gabriel-baroffaldi/3D_Photometer/README.md

3D Printable LED Photometer © 2025 by Gabriel Baroffaldi Piassalonga, Paulo Clairmont Feitosa de Lima Gomes, São Paulo State University is licensed under Creative Commons Attribution-ShareAlike 4.0 International. To view a copy of this license, visit https://creativecommons.org/licenses/by-sa/4.0/
