gabriel-baroffaldi/3D_Photometer/Readme.pdf

# 3D Printable LED Photometer

### Piassalonga, Gabriel Baroffaldi

gabriel.baroffaldi@unesp.br

de Lima Gomes, Paulo C. F. paulo.clairmont@unesp.br

### February 2025

## 1 Considerations

This photometer was built to be used with a micro-volume cuvette. For other cuvette models, changing the dimensions of the base may be necessary .ipt file.

## 2 List of Materials

- 1x BPW34;
- 1x Switch Mts102;
- 1x OPA344PA;
- 1x Resistor 1 MΩ;
- 1x Resistor 10 MΩ;
- 1x Resistor 220 Ω;
- 1x Potentiometer 10k kΩ;

1

- 2x Polyester Capacitor 10 nF;
- 1x LED;
- 1x Arduino;
- Wire 3 mm gauge.

## 3 Assembly Guide

Glue the photodiode to the recessed wall of the cell holder. Then, on the other side, the LED is glued. Finish the cell holder by gluing “Tampa LED” into the top where the LED was fixed. Be careful if using super glue; their vapors adhere over the LED and photodiode surface in excess.

Figure 1: Cuvette holder

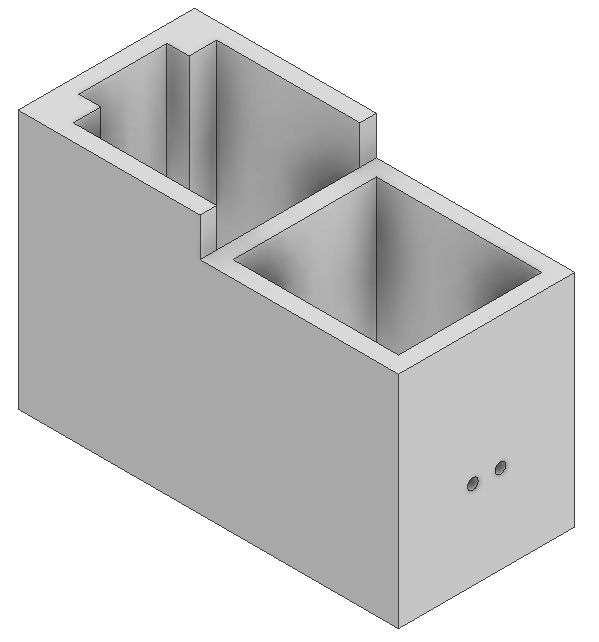
[picture p1: figure]

The PCB board design is provided in the following file: Schematics/Photo-

meter. We recommend that a specialized company produce the board. Solder the electronic components to the circuit board following the schematics:

2

Figure 2: Schematics of the photometer

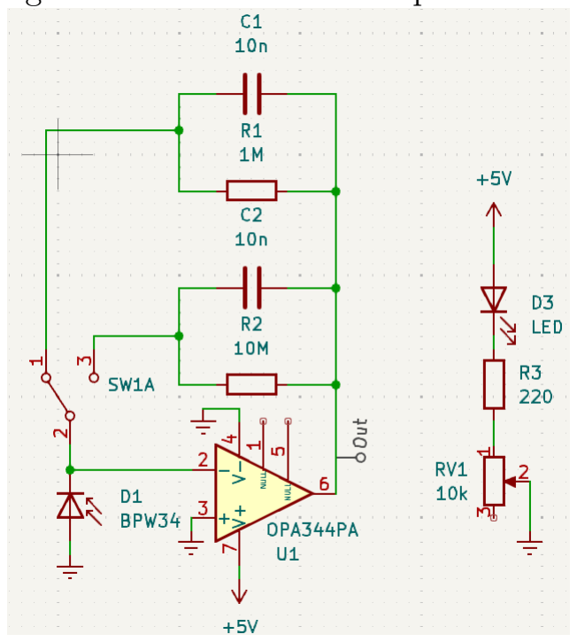
[picture p2: figure]

Place the switch and the potentiometer in the photometer box and measure the wire length necessary to connect the photodiode, LED, potentiometer, and switch Mts102 to the PCB board.
The PCB board needs three wires connected to the Arduino: 5 V, ground, and A0 analog ports. The solder is placed on the board and passes through the side of the box for the Arduino connection.
Glue the cuvette holder to the photometer box and close with the photometer cover.
The Arduino code can be found inside the example library of the Arduino IDE: Examples/Analog/Smoothing.

## 4 How to Use

Using the Serial Monitor from Arduino IDE, change the potentiometer settings to lower the signal.
Place the cuvette and read the value shown inside the Serial Monitor.

3

Absorbance can be calculated using the following formula:

Absorbace = −log(SampleSignal/BlankSample) | (1)

## 5 Dimensions

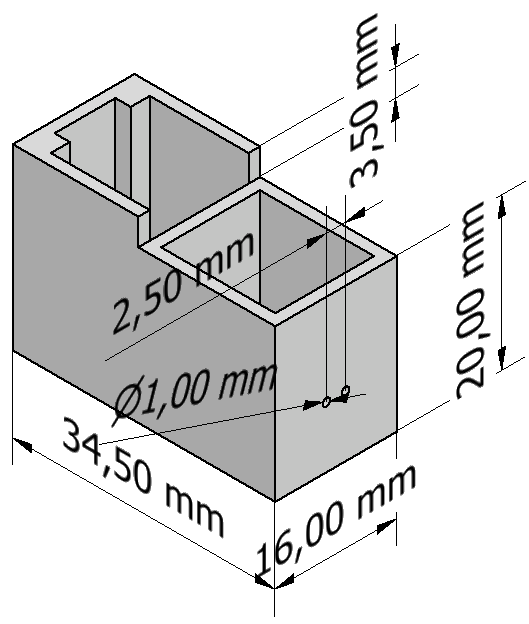
[picture p3: figure]

Figure 3: Dimensions of the cuvette holder.

4

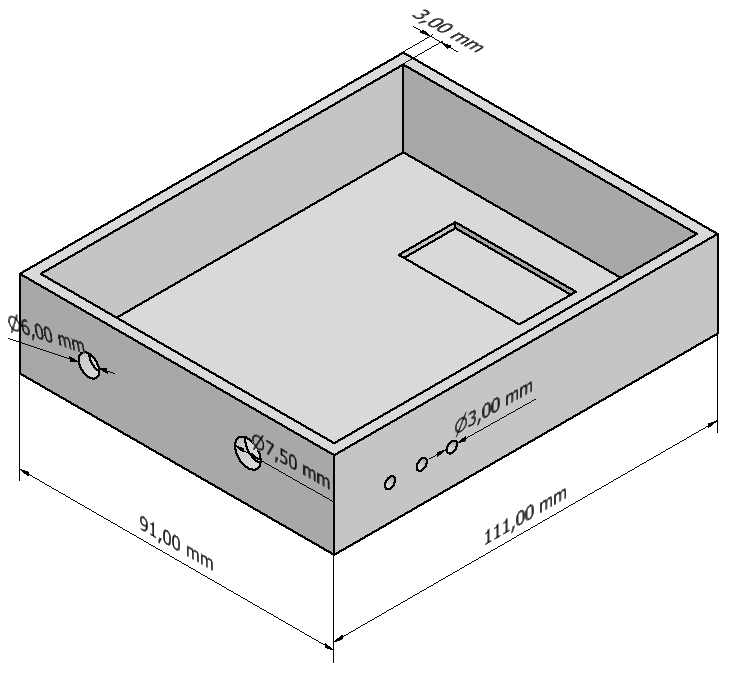
[picture p4: figure]

Figure 4: Dimensions of the photometer box.

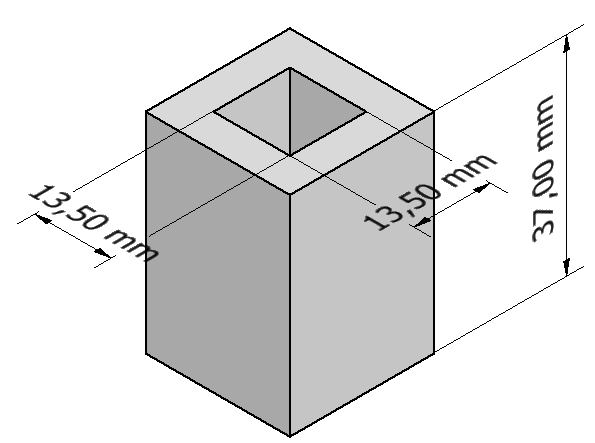
[picture p5: figure]

Figure 5: Dimensions of the cuvette cover.

5

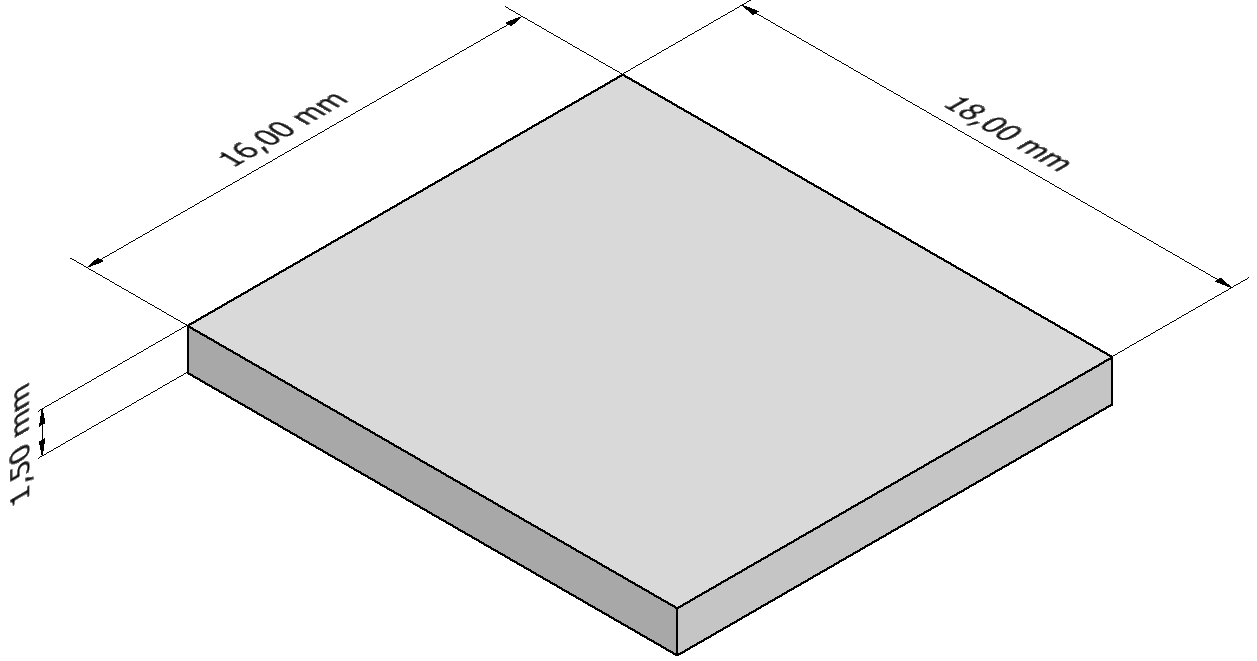
[picture p6: figure]

Figure 6: Dimensions of the LED cover.

Figure 7: Dimensions of the photometer cover.

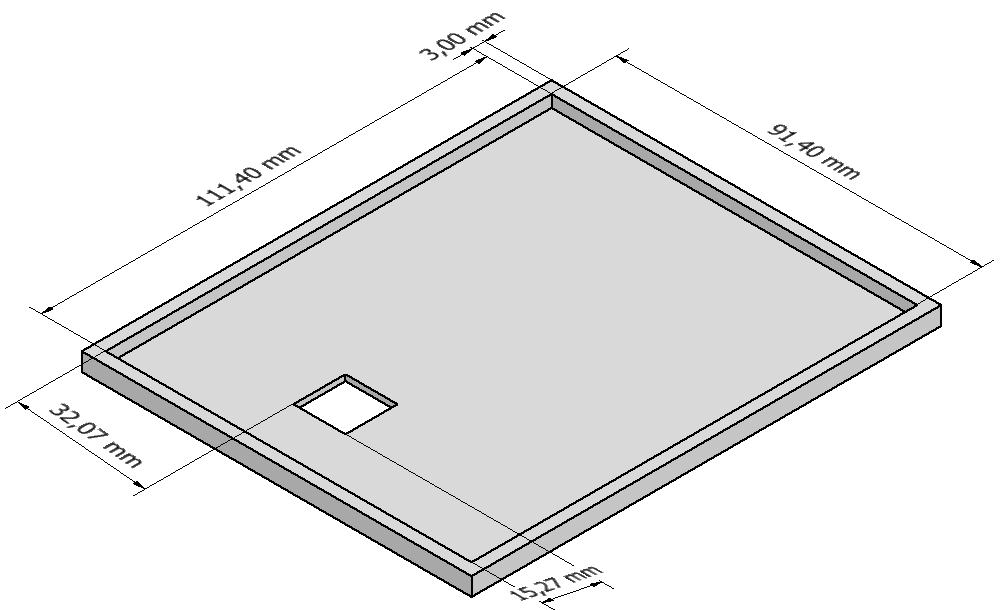
[picture p7: figure]

## 6 License

3D Printable LED Photometer © 2025 by Gabriel Baroffaldi Piassalonga,

Paulo Clairmont Feitosa de Lima Gomes, S˜ao Paulo State University is licensed under Creative Commons Attribution-ShareAlike 4.0 International.

6

To view a copy of this license, visit https://creativecommons.org/licenses/bysa/4.0/

7
