gabriel-baroffaldi/3D_Photometer/CAD/Caixa.stl

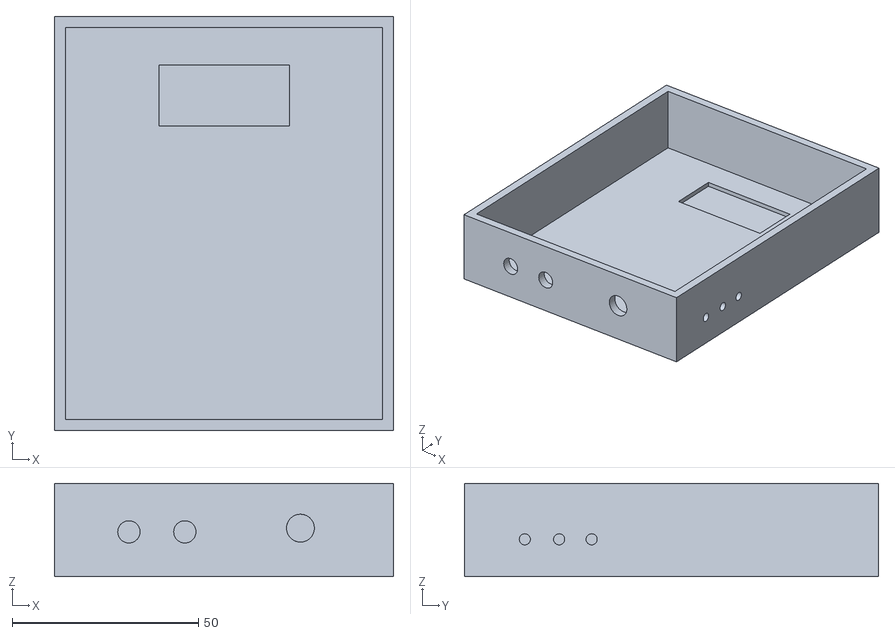
[picture p8: CAD file, 2025-02-11]
CAD/Caixa.stl
91.0 x 111.0 x 25.0
