gabriel-baroffaldi/3D_Photometer/CAD/Base.stl

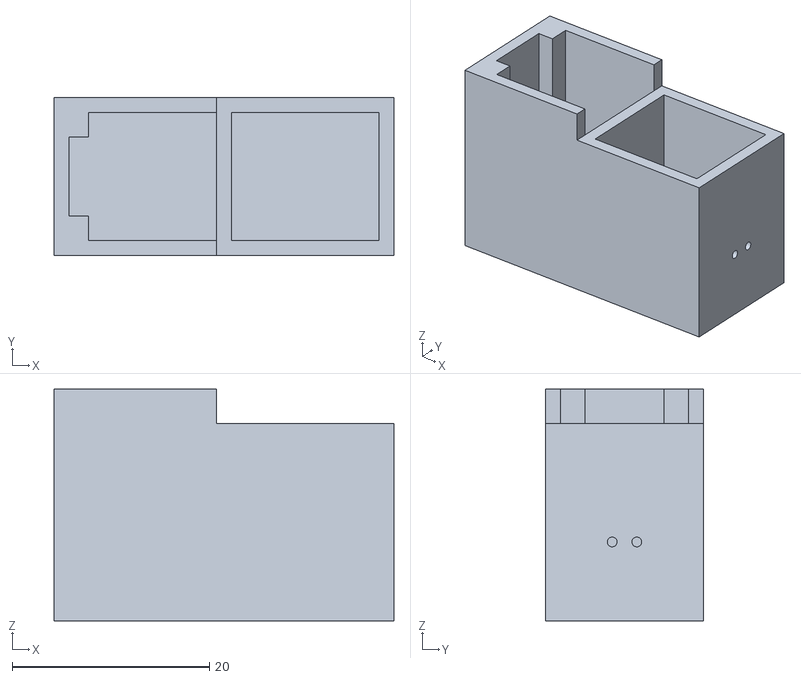
[picture p9: CAD file, 2025-02-10]
CAD/Base.stl
34.5 x 16.0 x 23.5
