gabriel-baroffaldi/3D_Photometer/CAD/Tampa_fotometro.stl

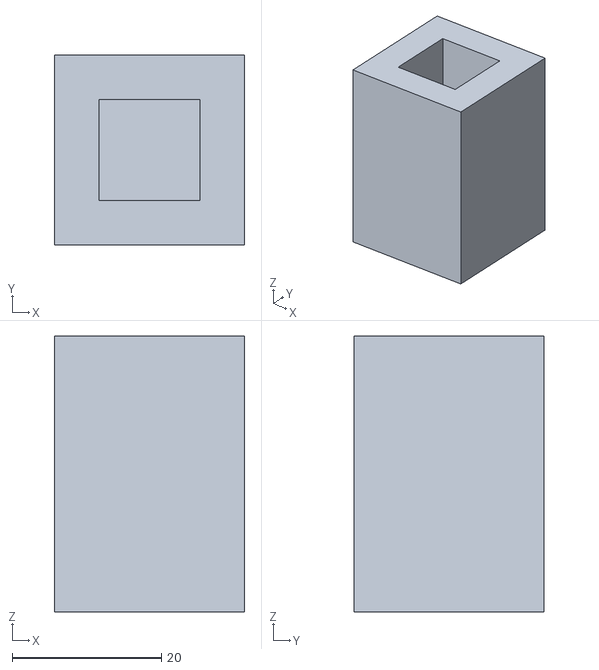
[picture p10: CAD file, 2025-02-10]
CAD/Tampa_fotometro.stl
25.5 x 25.5 x 37.0
