gabriel-baroffaldi/3D_Photometer/CAD/Tampa-led.stl

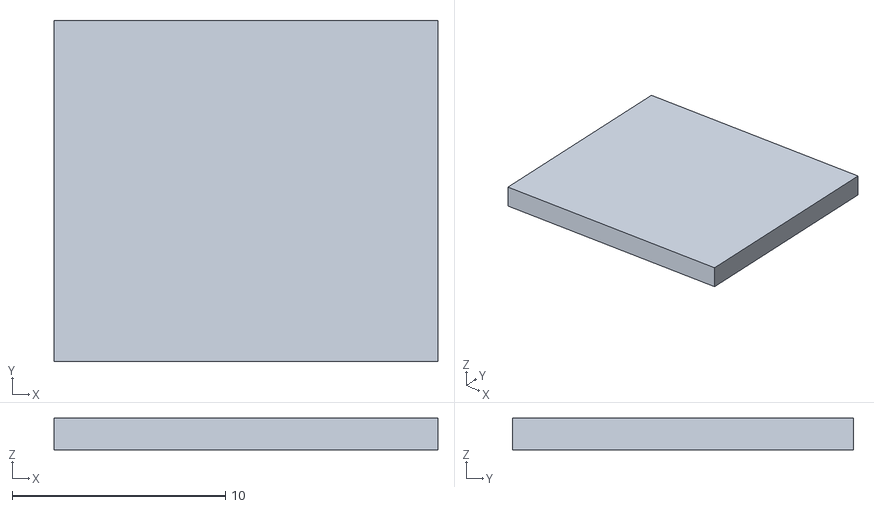
[picture p11: CAD file, 2025-02-10]
CAD/Tampa-led.stl
18.0 x 16.0 x 1.50
