gabriel-baroffaldi/3D_Photometer/CAD/Tampa.stl

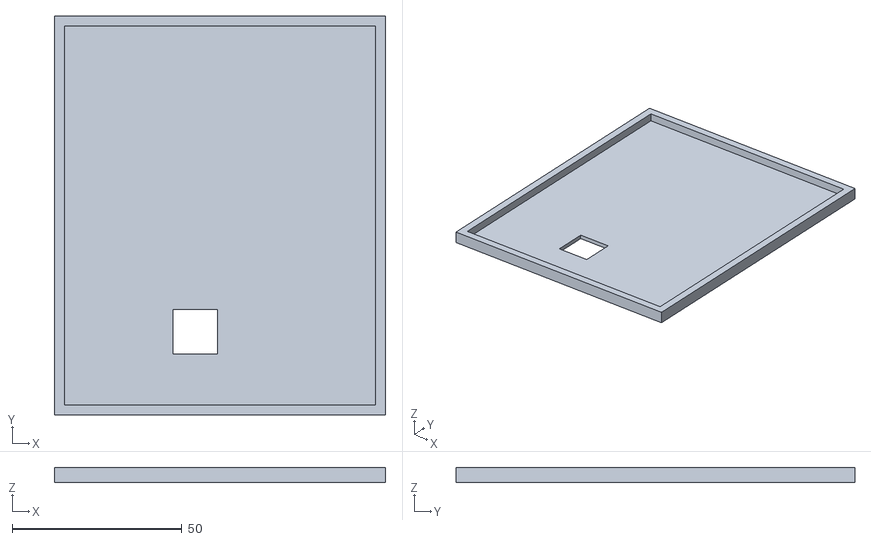
[picture p12: CAD file, 2025-02-10]
CAD/Tampa.stl
97.4 x 117.4 x 4.50
