gabriel-baroffaldi/3D_Photometer/(list of files, cad)

Other CAD files:
CAD/Base.ipt
CAD/Caixa.ipt
CAD/Tampa-led.ipt
CAD/Tampa.ipt
CAD/Tampa_fotometro.ipt
