gabriel-baroffaldi/3D_Photometer/Schematics/Photometer.kicad_pcb

## KiCad design Schematics/Photometer.kicad_pcb (2025-02-11)

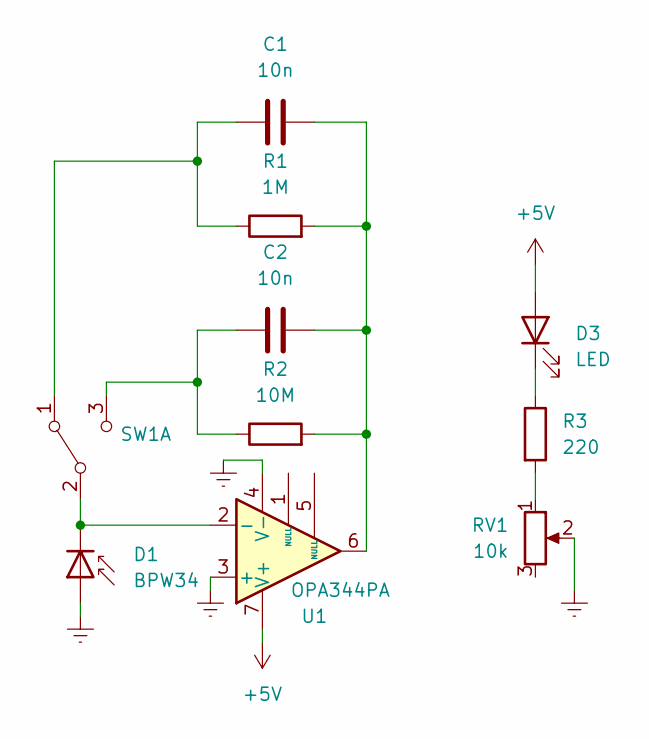
[picture p13: schematic Photometer.kicad_sch]

Parts:
C1, C2: 10n; C_Rect_L9.0mm_W3.6mm_P7.50mm_MKT
D1: BPW34; SolderWire-0.1sqmm_1x02_P3.6mm_D0.4mm_OD1mm
D3: LED; SolderWire-0.1sqmm_1x02_P3.6mm_D0.4mm_OD1mm
R1: 1M; R_Axial_DIN0204_L3.6mm_D1.6mm_P7.62mm_Horizontal
R2: 10M; R_Axial_DIN0204_L3.6mm_D1.6mm_P7.62mm_Horizontal
R3: 220; R_Axial_DIN0204_L3.6mm_D1.6mm_P7.62mm_Horizontal
RV1: 10k; SolderWire-0.1sqmm_1x03_P3.6mm_D0.4mm_OD1mm
SW1: SW_DPDT_x2; SolderWire-0.1sqmm_1x03_P3.6mm_D0.4mm_OD1mm
U1: OPA344PA; DIP-8_W7.62mm_Socket_LongPads

Connections:
+5V: D3.2 (A), U1.7 (V+)
Earth: D1.2 (A), RV1.2, U1.3 (+), U1.4 (V-)
unnamed: C1.2, C2.2, R1.2, R2.2, U1.6
unnamed: D1.1 (K), SW1.2 (B), U1.2 (-)
unnamed: D3.1 (K), R3.1
unnamed: R3.2, RV1.1
unnamed: C1.1, R1.1, SW1.1 (A)
unnamed: C2.1, R2.1, SW1.3 (C)

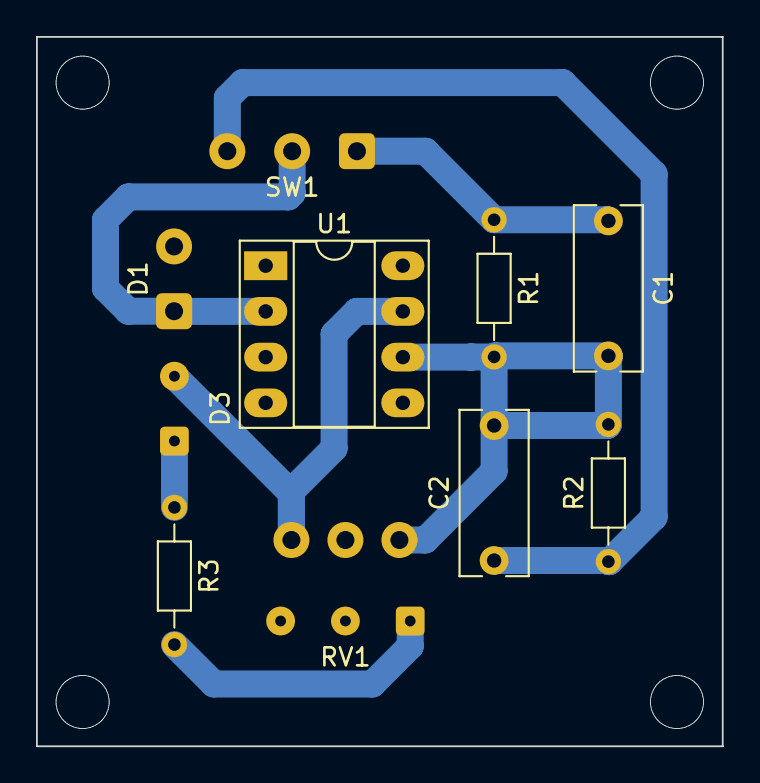
[picture p14: board Photometer.kicad_pcb from above]

Board: 2 copper layers, 38.1 x 39.4 mm, 10 parts (0 on the bottom side), 8 nets.
